Cactus-ar/16b_cpu/(commit log)

2026-08-02 conector y primer esquema del reloj
    [Modulo_01_Reloj.kicad_pcb, Modulo_01_Reloj.kicad_sch, conectores.kicad_sch]
2026-08-15 mod reloj_cont
    [Modulo_01_Reloj.kicad_sch]
2026-08-15 fix + revision
    [Modulo_01_Reloj.kicad_sch]
2026-08-16 fix de estructura, nueva orientacion
    [Modulo_01_Reloj.kicad_pcb, Modulo_01_Reloj.kicad_sch, conectores.kicad_sch]
2026-08-17 reestructura de docs al esquema numerado y correccion de discrepancias
    Renombra al esquema que CLAUDE.md asumia (00-bus-spec, componentes,
    modulos/) y resuelve los items 1, 2, 6-11, 15 y 16 de PENDIENTES.
    Registra el hallazgo de designadores doc/esquematico como item 20.
    [conectores.kicad_sch]
2026-08-17 reconstruccion del spec del ISA (01-isa-spec.md)
    El original se perdio sin entrar al repo. Reconstruido desde PENDIENTES,
    README y bus-spec: formatos con imm8, opcodes completos (1100 HALT,
    1101 sistema, 1111 prefijo de expansion), microcodigo de las 16
    instrucciones e interrupciones. Lo derivado sin registro previo lleva
    marca [PROPUESTO - validar], listado en s11; no es normativo hasta
    revision del autor.
2026-08-17 gitignore para .history de VS Code y temporales de KiCad
2026-08-17 validacion del ISA: decisiones de s11 confirmadas por el autor
    SLT con signo (decision explicita, logica N xor V en la ALU), base
    PC+1, BEQ/BNE pisan banderas, subcampo de sistema, contador de 3 bits,
    y el resto del bloque mecanico. Queda pendiente solo la lectura ciclo
    por ciclo de las secuencias de s6.3. El documento pasa a v0.2,
    normativo salvo esa seccion.
2026-08-17 PENDIENTES: referencia vieja a marcas de s7 ya validadas
2026-08-17 ISA v0.3 normativo: microcodigo de s6.3 validado ciclo por ciclo
    Validacion por grupos (aritmetica, memoria, saltos, indirectos y E/S).
    Nueva restriccion documentada surgida de la revision: JALR exige
    rd != rs (el enlace pisa la fuente y el salto cae al fall-through);
    el ensamblador debe rechazarlo. Cierra el item 19 de PENDIENTES.
2026-08-17 componentes: faltantes detectados al validar la lista para el pedido
    - Banco de registros: 4 SRAM AS6C62256 que no estaban (2 copias x 2
    chips para 16 bits). Memoria pasa de 10/26 a 14/34 chips.
    - 74HC148: plan B del 74C922, no figuraba.
    - Electromecanicos del modulo 01 (trimpot 20k, pote 1M, rotativo de
    3 posiciones, SPDT, pulsadores) llevados a la lista maestra.
    - Zocalos DIP-28: 15 -> 20 por el nuevo total de memoria.
2026-08-17 verificacion de uso de componentes: pedido anclado al diseno
    - 74C922 descartado definitivamente (decision del autor): el modulo 10
    usa el codificador discreto; se elimina el unico chip obsoleto del
    pedido.
    - EEPROM de reserva del generador de inmediatos: confirmadas.
    - Registrada en el ISA s10 la cuenta preliminar de ~33 senales de
    control vs 32 salidas de 4 ROMs (compactar o quinta ROM; la compra
    ya lo cubre).
2026-08-18 mapa de memoria (03-memoria-spec) y SWP en el opcode 1110
    Tres espacios separados por senal (programa/datos/puertos, cero
    decodificacion en v1), 32K poblados por espacio con expansion via A15,
    reset 0x0000, vector 0x0004, monitor 4K, pila por convencion R6.
    SWP (prog[rs+imm] <- rd via PROG_WE_n) habilita que el monitor cargue
    programas: gasta el ultimo opcode libre a proposito; el prefijo 1111
    queda para el resto. Cierra los items 3 y 12 de PENDIENTES y
    desbloquea el diseno de los modulos 7 y 8.
2026-08-18 specs: dos bancos de programa en v1 — requisito de SWP
    La EEPROM entera deja de devolver datos durante su ciclo interno de
    escritura (~10 ms); con monitor y usuario en los mismos chips, el
    primer SWP haria que el monitor se lea como basura. USER_BASE pasa a
    0x8000 (banco alto, A15=1, par propio); el banco bajo es del monitor
    y solo lo escribe el programador. Memoria de programa: 2 -> 4 chips,
    absorbidos por el margen del pedido.
2026-08-18 tools: ensamblador (asm16) y emulador (emu16) en C++17
    isa16.hpp: tabla unica del encoding, mapa de memoria y ciclos por
    instruccion — compartida por ambas herramientas para que no puedan
    divergir. asm16: dos pasadas, pseudos (LI/PUSH/POP/...), validaciones
    normativas (rangos, JALR rd!=rs), salida .bin + .lo/.hi para las dos
    EEPROM + listado. emu16: fiel al ISA v0.3 hasta en los detalles feos
    (R0 clavado, saltos pisan banderas, hazard de JALR), interrupciones,
    contador de ciclos reales y modelo de EEPROM ocupada tras SWP.
    Solucion de Visual Studio (v145) + build.sh/bat para g++.
    Cinco tests pasando: suma, hola (imprime por puerto), pila/subrutina,
    irq (ISR completa con RETI), swp (detecta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
2026-08-18 emu16: opcion --log ARCHIVO para la traza y el estado final
    La consola del programa (puerto 0) queda en pantalla y los avisos en
    stderr; traza, estado final y volcados van al archivo. Permite estudiar
    la ejecucion completa sin mezclarla con la salida del programa.
2026-08-20 tests: pi.s — 525 decimales de pi por spigot, overflow por software
    Rabinowitz-Wagon en 16 bits: mul16 shift-add, div16 restoring y
    deteccion de overflow con el idiom de comparacion sin signo (la
    bandera C del hardware no es observable: ninguna instruccion la
    consume). Con LEN=1750 imprime 525 decimales verificados contra una
    referencia C de semantica uint16 identica; con LEN=1800 la aritmetica
    desborda en la pasada 5 y el programa lo detecta e imprime OVERFLOW.
    En la maquina real: 490M instrucciones, 2210M ciclos, 1h17m a 480 kHz.
2026-08-20 tests: fib.s — Fibonacci hasta el overflow, con impresion decimal
    F(1)..F(24) en decimal y deteccion aritmetica del overflow al calcular
    F(25)=75025 (no entra en 16 bits), anunciando el indice. Novedades:
    print16 (conversion binario->decimal por divisiones por 10, restos
    apilados con PUSH/POP y centinela) y enlace anidado (print16 llama a
    div16 y salva R7 en la pila). 21K instrucciones, 0,19 s a 480 kHz.
2026-08-21 specs: microcodigo fijado — 5 ROMs directas, IMM_SEL2 y latch de IRQ
    Decisiones del autor al escribir el microensamblador:
    - 5 EEPROM de control con senales directas (37 usadas, 3 de margen),
    contra la alternativa de 4 ROMs + decodificador; el invariante de un
    emisor lo verifica la herramienta, no el hardware.
    - Direccion de ROM fijada: A13..A0 = op(4)·funct(3)·T(3)·Z·C·IRQ·IE.
    - Asignacion de salidas por ROM (normativa para el layout de la 9).
    Consecuencias de hardware destapadas al bajar a bits:
    - IMM_SEL2: el vector 0x0004 es constante, no campo del IR, y los 4
    modos de 2 bits estaban ocupados (ISA s5, modo 100).
    - IRQ_n se muestrea en el limite de instruccion (flip-flop en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
2026-08-21 tools: microensamblador (ucode16) — las 5 ROMs de control reales
    Genera build/ucode0..4.bin (16K c/u, nivel electrico: chip borrado =
    bus inactivo) desde el microcodigo del ISA s6.3/s7, mas listado
    legible. Verificacion estatica: exactamente un emisor de bus en cada
    una de las 16384 direcciones; estados inalcanzables rellenos con
    bus-keeper + fin de instruccion. Estos archivos son los que el T48
    grabara en las EEPROM de la tarjeta 9.
2026-08-21 tools: ucode16 en los scripts de build y en la solucion de VS
2026-08-21 tools: usim16 — simulador a nivel de microciclo sobre las ROMs reales
    No sabe que es una instruccion: datapath fisico (PC, IR, MAR, TMPA/B,
    banco, ALU, banderas, IE, latch de IRQ, contador T) gobernado ciclo a
    ciclo por las cinco imagenes de ucode16. Traza y estado final en
    formato identico a emu16: la verificacion es un diff.
    Resultado: los 7 tests IDENTICOS entre ambos simuladores — incluidas
    la interrupcion completa y pi (490M instrucciones, 2211M microciclos
    reales). El microcodigo implementa el ISA, verificado antes de tocar
    Digital o hardware. De paso: dis() compartido en isa16.hpp y CYC_IRQ
    corregido de 3 a 2 (la atencion es Ta+Tb; el chequeo no paga ciclo —
    la ROM real lo desm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
